corecode/kicad-libs/APTF1616.STEP

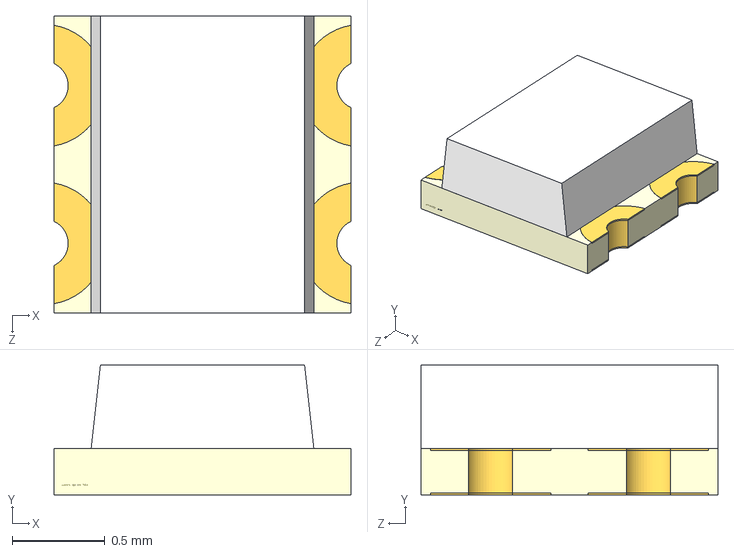
[picture p1: CAD file, 2022-03-17]
APTF1616.STEP
1.60 x 0.7 x 1.60 mm
