corecode/kicad-libs/digital_microphone.step

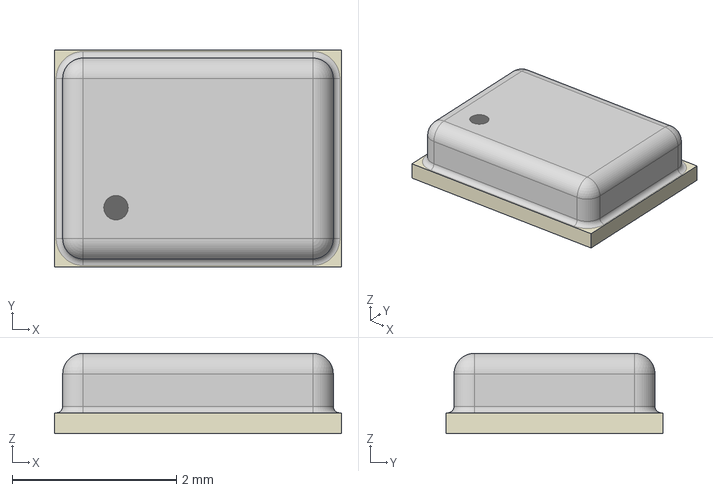
[picture p2: CAD file, 2022-01-13]
digital_microphone.step
3.50 x 2.65 x 0.98 mm
