corecode/kicad-libs/HYC04-TF09-200.step

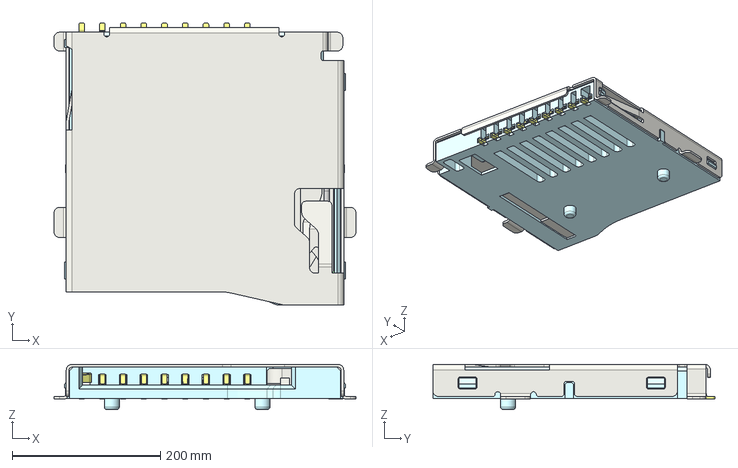
[picture p3: CAD file, 2019-05-19]
HYC04-TF09-200.step
407.4 x 381.0 x 61.0 mm
