corecode/kicad-libs/WL-SFSW-155124M173200.stp

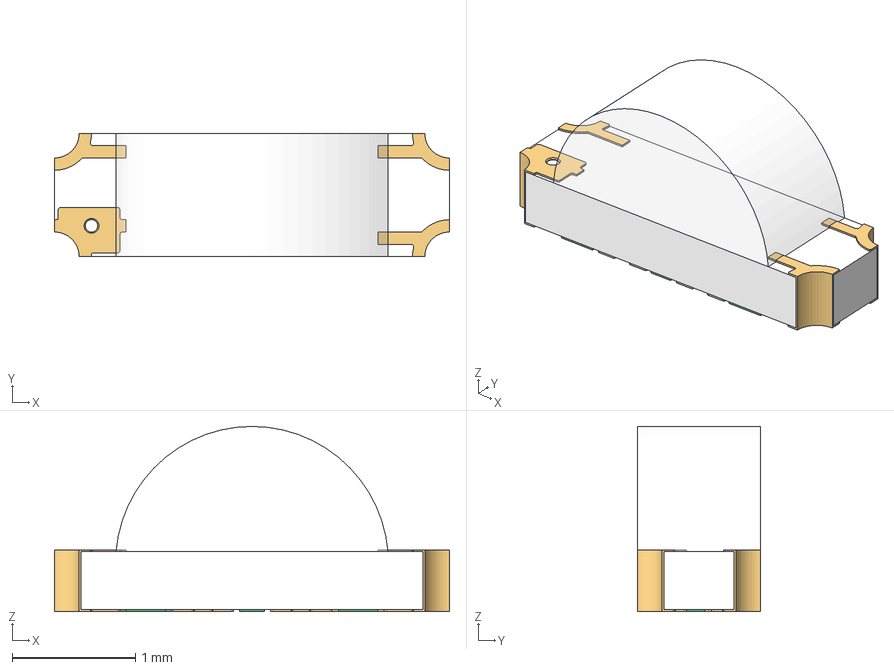
[picture p4: CAD file, 2019-05-16]
WL-SFSW-155124M173200.stp
3.20 x 1.00 x 1.50 mm
housing
contacts
cap
