corecode/kicad-libs/1TS003B.step

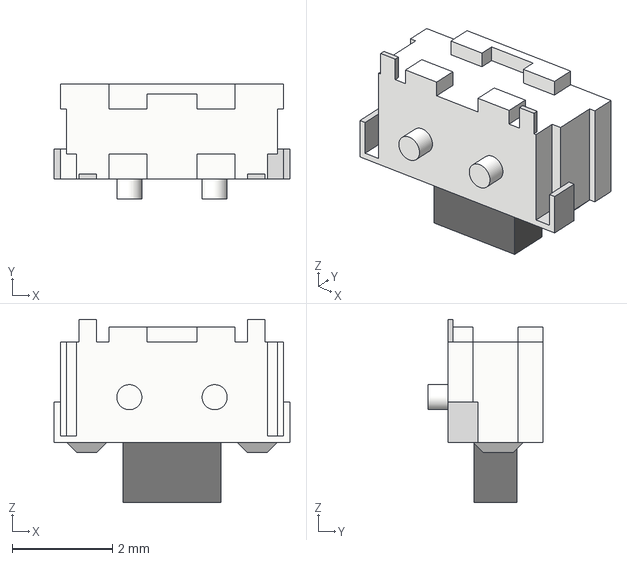
[picture p6: CAD file, 2019-05-16]
1TS003B.step
4.70 x 2.30 x 3.65 mm
