corecode/kicad-libs/(list of files, cad)

Other CAD files:
digital_microphone.FCStd
