corecode/kicad-libs/(commit log)

2014-08-22 add footprint generator script
2014-10-05 add thermistor
2014-10-09 add power flag and sot-23-fet
2014-10-13 add footprints
2014-10-13 fix jtag connector symbol
2014-10-15 reduce gnd label size
2014-10-17 add hole symbol/footprint
2014-10-17 adjust footprint/symbols
2014-10-28 composite hole with multiple pads
2014-11-01 gen-fp: add solder paste for flag
2014-11-04 convert and add micro usb connectors
2014-11-04 add dual led
2015-04-25 update footprints
2015-04-27 header-1x2: change silkscreen size
2015-06-05 add SOD-523 (diode)
2015-06-28 more parts & footprints. transitioning to larger symbols
2015-08-25 increase schottky wings
2015-08-25 add EE2 relay
2015-08-25 add screw terminal
2015-09-03 add analog switches
2015-09-03 enlarge solder jumper
2015-09-08 modernize 1608 led
2015-10-31 add SLP3 light pipe footprint
2015-11-22 add voltage symbols vusb, vtarget
2015-11-30 gen-fp: update for new footprint style
2015-12-06 add footprint
2015-12-06 add silkscreen
2015-12-20 add 5mm pitch 8.2mm wide PTH terminal
2016-05-05 add 5v isol
2016-05-09 add 6mm tactile
2016-05-09 fix 6.3mm CP
2016-05-11 add header footprints
2016-05-14 footprints and components
2016-05-14 fix rj45 footprint
2016-05-19 add pin 1 marker to soic-8-n fab layer
2016-05-19 fix molex minifitjr pin spacing
2016-06-06 fix usb connector a bit
2016-06-06 footprints & symbols
2016-06-23 fix footprint name
2016-06-24 fix lpc824 pin label
2017-01-18 increase thermistor symbol size
2017-01-23 add 0.5mm fiducial
2017-01-24 add 12v symbol
2017-03-08 osc and led fixes
2017-03-19 add 3-way diodes
2017-04-10 parts for current monitor
2017-06-11 add 0.3mm drill
2017-07-22 add ISP130301 and MSOP-10 footprints
2017-08-20 add button and usb plug
2017-08-27 edge cuts for button
2017-11-04 remove old kicad footprint format files
2018-02-22 add sod footprints
2018-04-30 add 20 pin jtag header
2018-05-30 fix jst ph-2 footprint
2018-09-06 update lga footprints
2019-01-15 mark footprint as SMD
2019-05-16 change footprint field visibility
2019-05-16 add new parts
    [1TS003B.step, HYC04-TF09-200.step, WL-SFSW-155124M173200.stp, cap-size-code-g-v.stp]
2019-05-17 tie down vias on hole
2019-05-19 adjust ethernet jack case color
2019-05-19 remove pink color from model
    [HYC04-TF09-200.step]
2019-05-22 add smd resistor
2019-06-04 HOLE-M3: correctly specify paste hole for alignment
2020-08-18 add connectors
2020-08-18 add esp32-pico-v3
2020-08-18 move fuse symbol anchor
2020-08-21 add parts, revert to kicad 5.1
2020-08-21 esp-pico footprint: reduce number of vias
2020-08-21 usb footprint: move lines from fab to drawings layer
2020-09-22 match ledstrip pads to Mark's design
2020-10-02 add hirose USB connector
2021-12-11 esp32-pico-qfn: change center pad to match reference design
    resized to 5.4mm, solder paste ratio 65%
2022-01-05 convert symbols to new kicad format
2022-01-12 add digital microphone
    [digital_microphone.FCStd, digital_microphone.step]
2022-01-13 update digital microphone
    [digital_microphone.FCStd, digital_microphone.step]
2022-03-17 add LED1616 3D model
    [APTF1616.STEP]
2022-06-28 add pogo pins and connector
2022-12-19 change kicad6 3d model dir variable name
2023-01-11 more parts/antennas
2023-05-26 lga12: drop custom solder mask clearance
2023-06-14 remove old kicad symbol files
2023-07-06 add side mount button, panasonic EVPAKE31A
